todbot/TS20_Test_Board/schematics/TS20_Test_Board/TS20_Test_Board.kicad_pcb

## KiCad design schematics/TS20_Test_Board/TS20_Test_Board.kicad_pcb (2024-03-07)

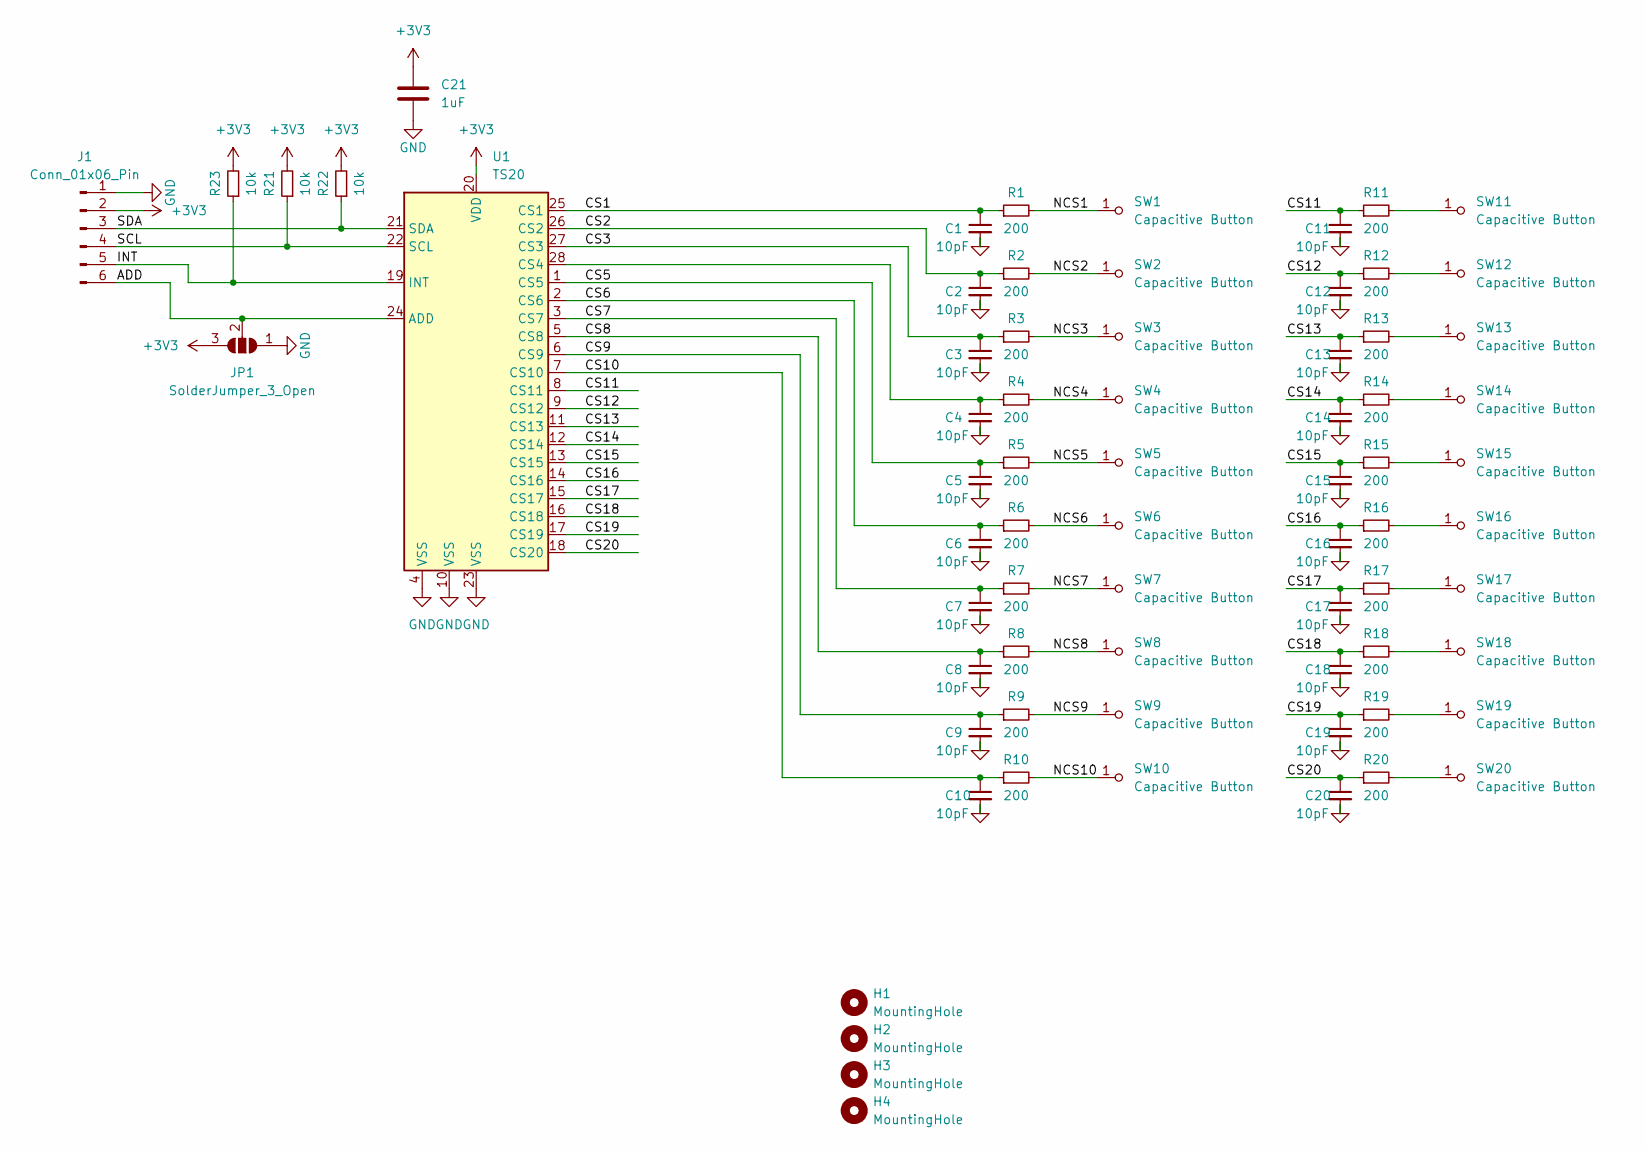
[picture p1: schematic TS20_Test_Board.kicad_sch]

Parts:
C1, C2, C3, C4, C5, C6, C7, C8, C9, C10, C11, C12, C13, C14, C15, C16, C17, C18, C19, C20: 10pF; C_0603_1608Metric
C21: 1uF; C_0603_1608Metric
H1, H2, H3, H4: MountingHole; MountingHole_2.5mm
J1: Conn_01x06_Pin; PinHeader_1x06_P2.54mm_Vertical
JP1: SolderJumper_3_Open; SolderJumper-3_P1.3mm_Open_RoundedPad1.0x1.5mm
R1, R2, R3, R4, R5, R6, R7, R8, R9, R10, R11, R12, R13, R14, R15, R16, R17, R18, R19, R20: 200; R_0603_1608Metric
R21, R22, R23: 10k; R_0603_1608Metric
SW1, SW2, SW3, SW4, SW5, SW6, SW7, SW8, SW9, SW10, SW11, SW12, SW13, SW14, SW15, SW16, SW17, SW18, SW19, SW20: Capacitive Button; Pad-CapacitiveTouch
U1: TS20; TSSOP-28_4.4x9.7mm_P0.65mm

Connections:
+3V3: C21.1, J1.2, JP1.3 (B), R21.2, R22.2, R23.2, U1.20 (VDD)
/ADD: J1.6, JP1.2 (C), U1.24 (ADD)
/CS1: C1.1, R1.1, U1.25 (CS1)
/CS2: C2.1, R2.1, U1.26 (CS2)
/CS3: C3.1, R3.1, U1.27 (CS3)
/CS5: C5.1, R5.1, U1.1 (CS5)
/CS6: C6.1, R6.1, U1.2 (CS6)
/CS7: C7.1, R7.1, U1.3 (CS7)
/CS8: C8.1, R8.1, U1.5 (CS8)
/CS9: C9.1, R9.1, U1.6 (CS9)
/CS10: C10.1, R10.1, U1.7 (CS10)
/CS11: C11.1, R11.1, U1.8 (CS11)
/CS12: C12.1, R12.1, U1.9 (CS12)
/CS13: C13.1, R13.1, U1.11 (CS13)
/CS14: C14.1, R14.1, U1.12 (CS14)
/CS15: C15.1, R15.1, U1.13 (CS15)
/CS16: C16.1, R16.1, U1.14 (CS16)
/CS17: C17.1, R17.1, U1.15 (CS17)
/CS18: C18.1, R18.1, U1.16 (CS18)
/CS19: C19.1, R19.1, U1.17 (CS19)
/CS20: C20.1, R20.1, U1.18 (CS20)
/INT: J1.5, R23.1, U1.19 (INT)
/NCS1: R1.2, SW1.1 (A)
/NCS2: R2.2, SW2.1 (A)
/NCS3: R3.2, SW3.1 (A)
/NCS4: R4.2, SW4.1 (A)
/NCS5: R5.2, SW5.1 (A)
/NCS6: R6.2, SW6.1 (A)
/NCS7: R7.2, SW7.1 (A)
/NCS8: R8.2, SW8.1 (A)
/NCS9: R9.2, SW9.1 (A)
/NCS10: R10.2, SW10.1 (A)
/SCL: J1.4, R21.1, U1.22 (SCL)
/SDA: J1.3, R22.1, U1.21 (SDA)
GND: C1.2, C2.2, C3.2, C4.2, C5.2, C6.2, C7.2, C8.2, C9.2, C10.2, C11.2, C12.2, C13.2, C14.2, C15.2, C16.2, C17.2, C18.2, C19.2, C20.2, C21.2, J1.1, JP1.1 (A), U1.4 (VSS), U1.10 (VSS), U1.23 (VSS)
unnamed: R11.2, SW11.1 (A)
unnamed: R12.2, SW12.1 (A)
unnamed: R13.2, SW13.1 (A)
unnamed: R14.2, SW14.1 (A)
unnamed: R15.2, SW15.1 (A)
unnamed: R16.2, SW16.1 (A)
unnamed: R17.2, SW17.1 (A)
unnamed: R18.2, SW18.1 (A)
unnamed: R19.2, SW19.1 (A)
unnamed: R20.2, SW20.1 (A)
unnamed: C4.1, R4.1, U1.28 (CS4)

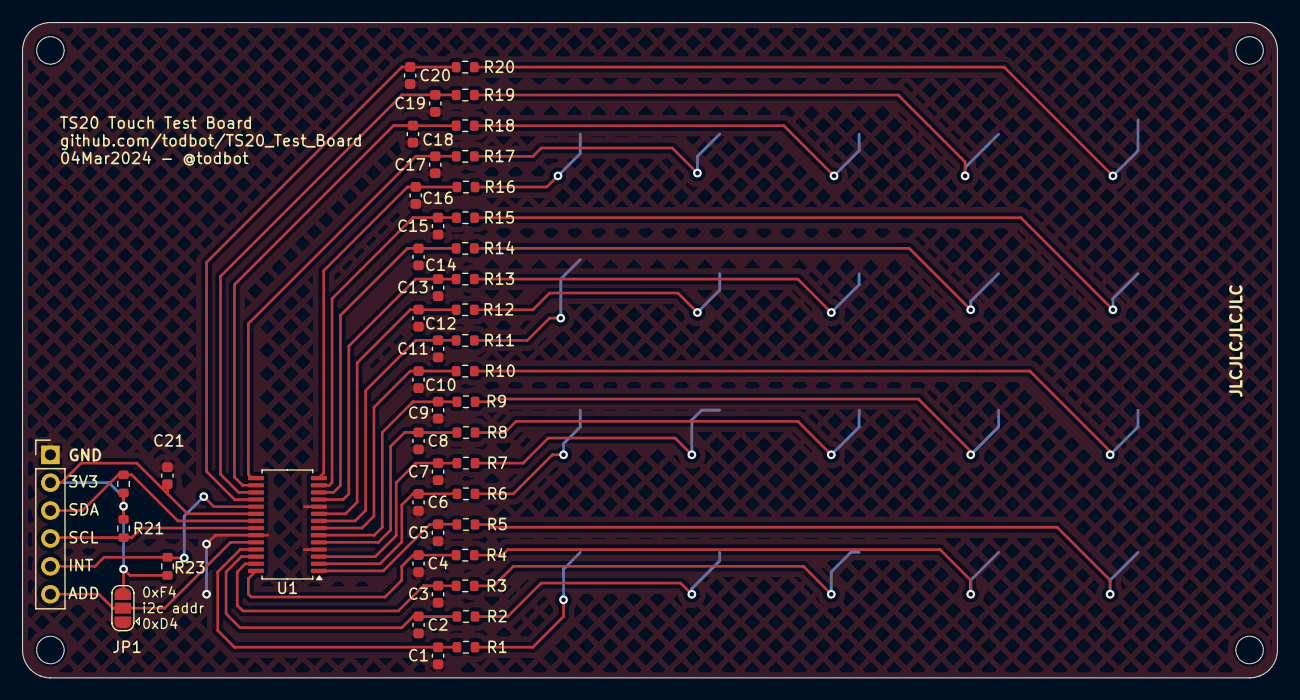
[picture p2: board TS20_Test_Board.kicad_pcb from above]

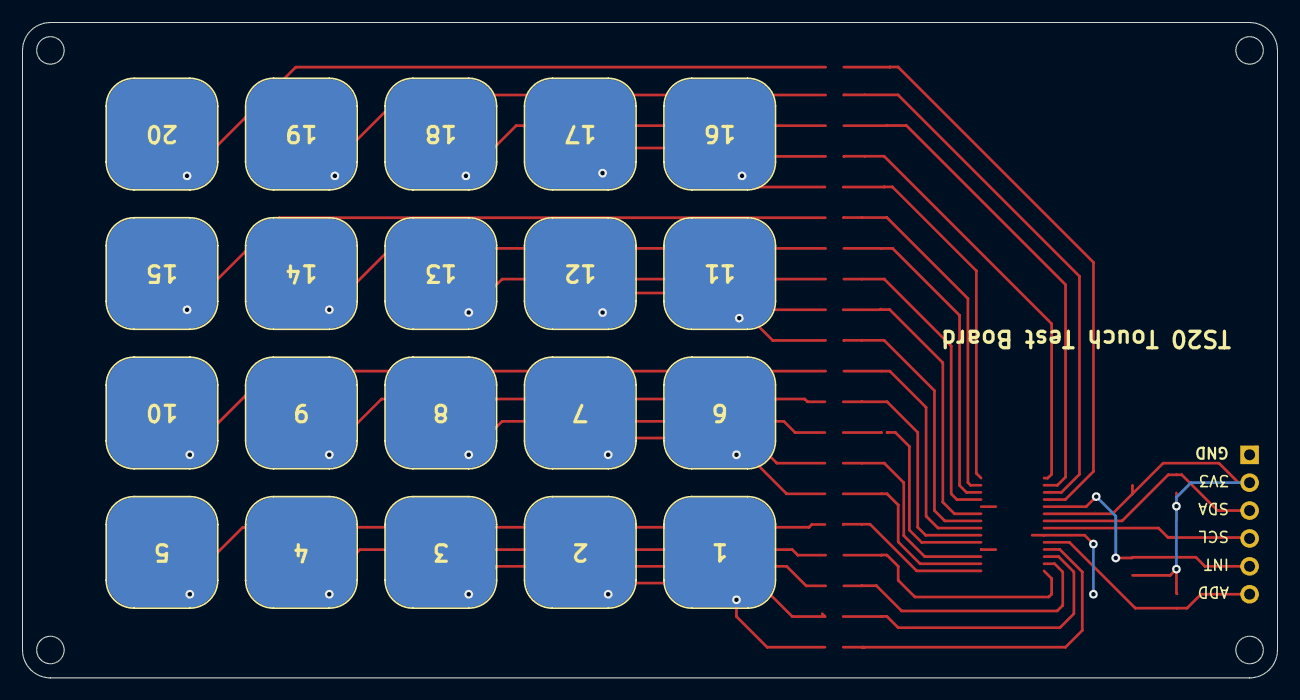
[picture p3: board TS20_Test_Board.kicad_pcb from below]

Board: 2 copper layers, 114.3 x 59.7 mm, 71 parts (20 on the bottom side), 46 nets.
