todbot/TS20_Test_Board/(commit log)

2024-03-07 add JLC marking
    [TS20_Test_Board.kicad_pcb]
2024-03-07 update gitignore for extra kicad dribble
2024-03-12 basic arduino library
2024-03-12 first cut at circuitpython lib
2024-03-13 circuitpython two board test
